kaulketh/outofoffice/hardware/5.83inch E-Paper E-Ink Display HAT For Raspberry Pi, 648×480 Pixels, Black _ White Dual-Color, SPI Interface.jpg

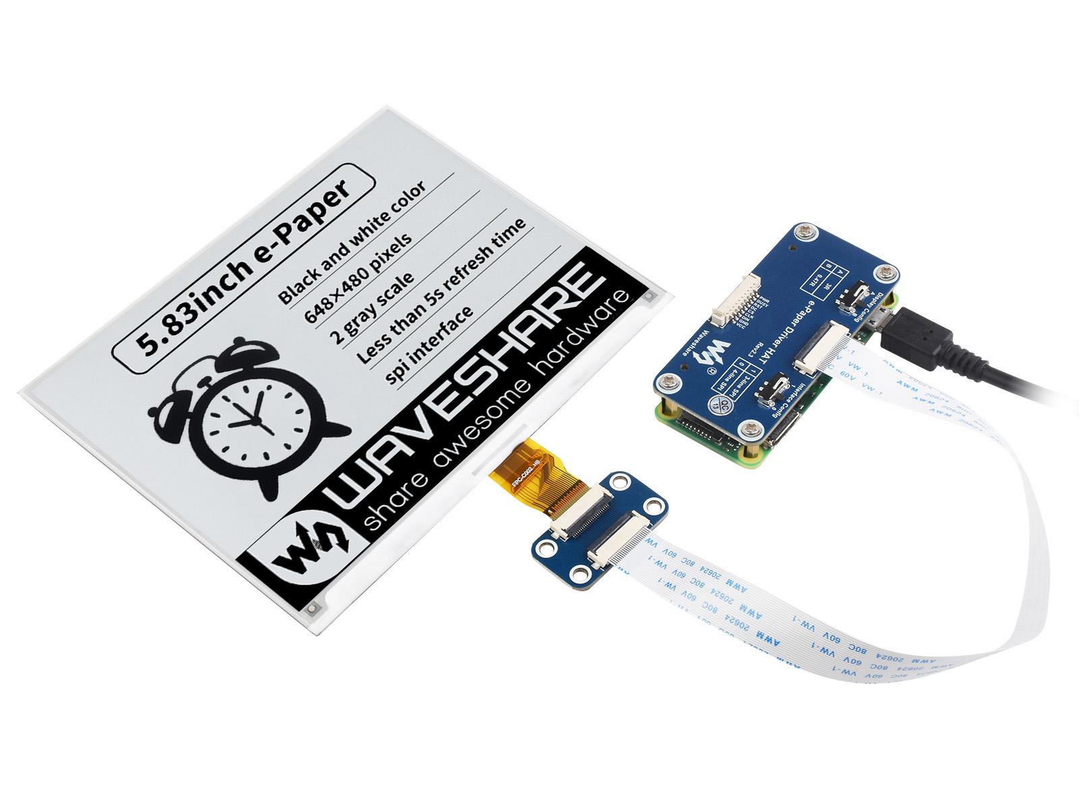
hardware/5.83inch E-Paper E-Ink Display HAT For Raspberry Pi, 648×480 Pixels, Black _ White Dual-Color, SPI Interface.jpg
