kaulketh/outofoffice/hardware/XIAO nrf52840 and I2S - XIAO - Seeed Studio Forum.jpg

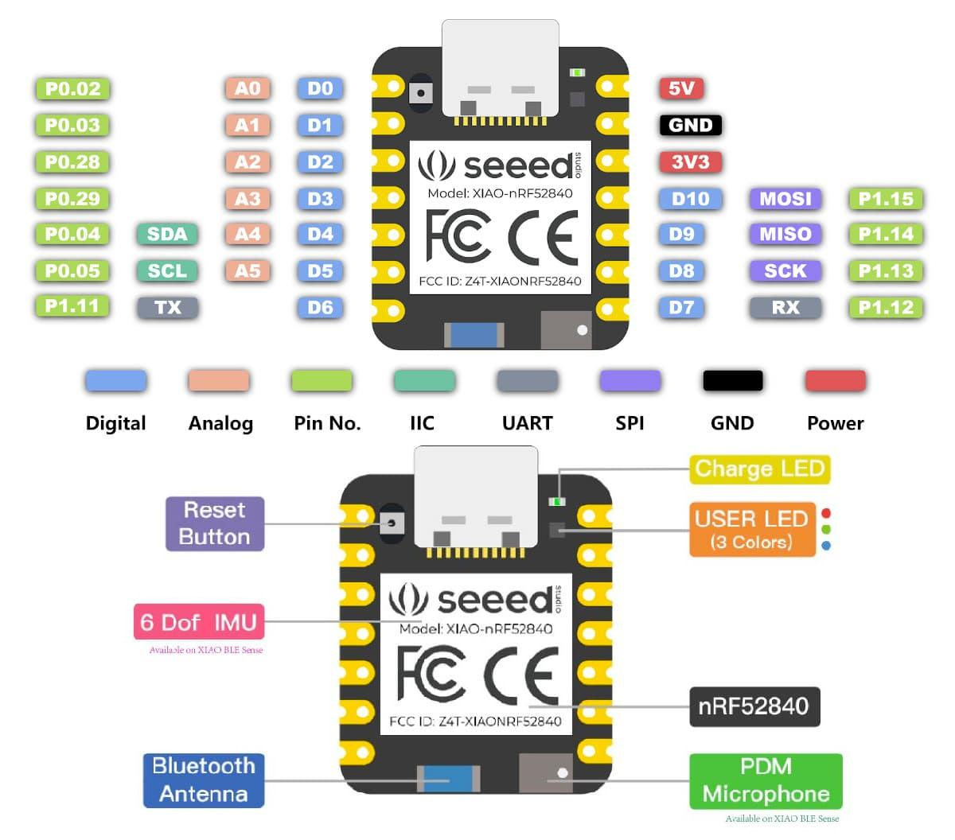
hardware/XIAO nrf52840 and I2S - XIAO - Seeed Studio Forum.jpg
