kaulketh/outofoffice/hardware/3D/xiao cover.stl

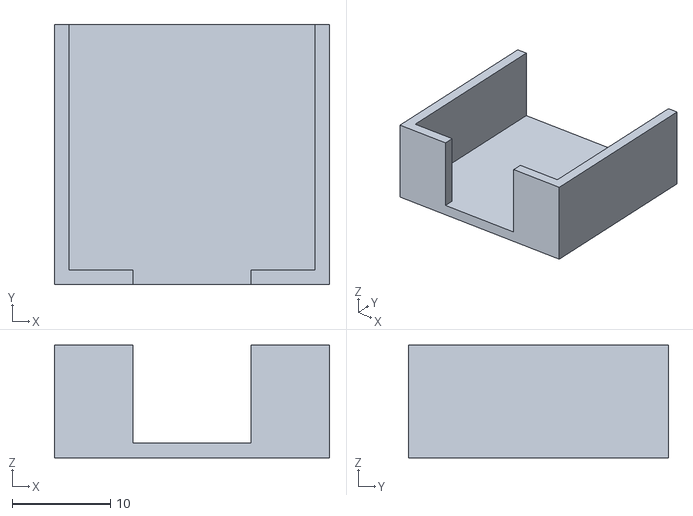
[picture p4: CAD file, 2026-11-11, last stored version]
hardware/3D/xiao cover.stl
28.0 x 26.5 x 11.5
