kaulketh/outofoffice/hardware/3D/enclosure.stl

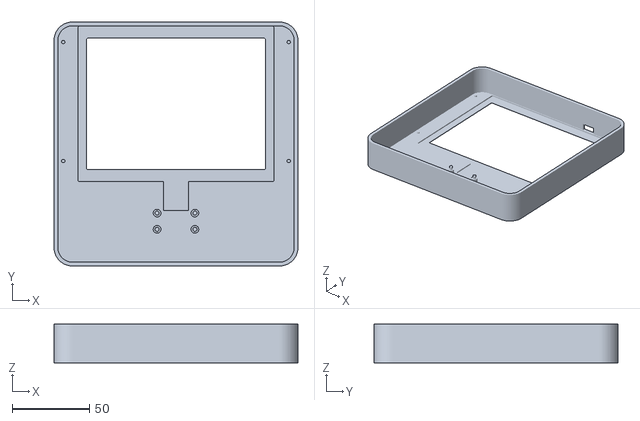
[picture p5: CAD file, 2026-11-11, last stored version]
hardware/3D/enclosure.stl
158.0 x 158.0 x 25.0
