kaulketh/outofoffice/hardware/3D/mount.stl

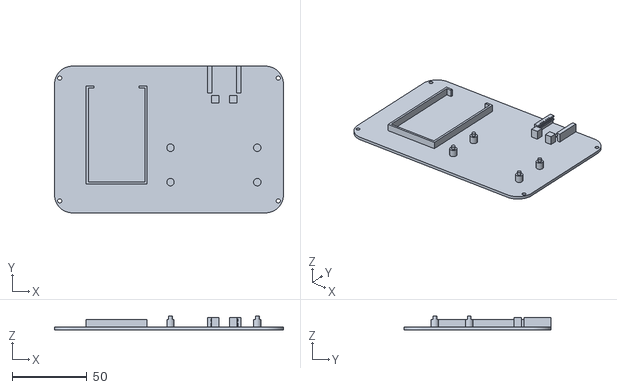
[picture p6: CAD file, 2026-11-11, last stored version]
hardware/3D/mount.stl
153.0 x 98.0 x 9.10
