kaulketh/outofoffice/hardware/3D/adapter cover.stl

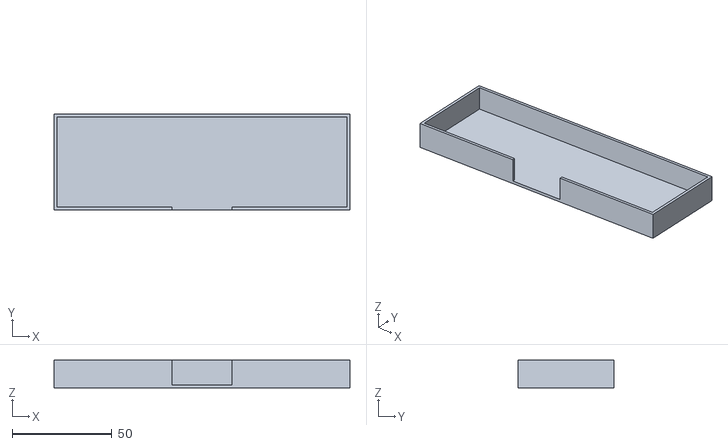
[picture p7: CAD file, 2026-11-11, last stored version]
hardware/3D/adapter cover.stl
148.0 x 48.0 x 13.8
