kaulketh/outofoffice/hardware/wiring.pdf

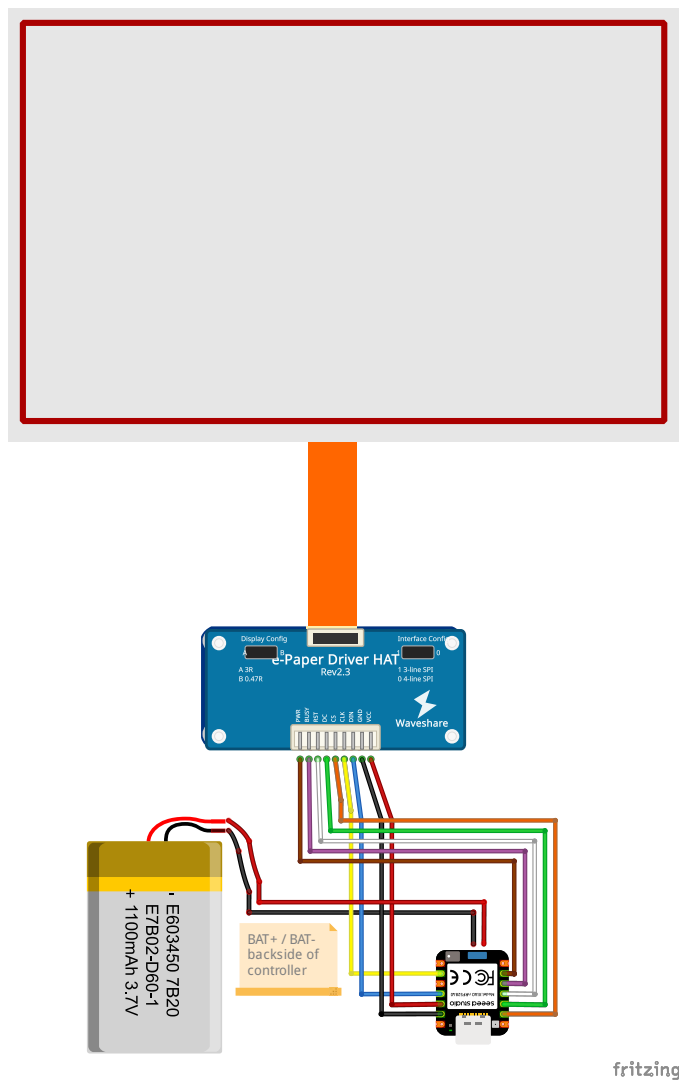
[picture p8: page 1]
BAT+ / BAT- backside of controller
