kaulketh/outofoffice/assets/kaulketh-maker-projects.png

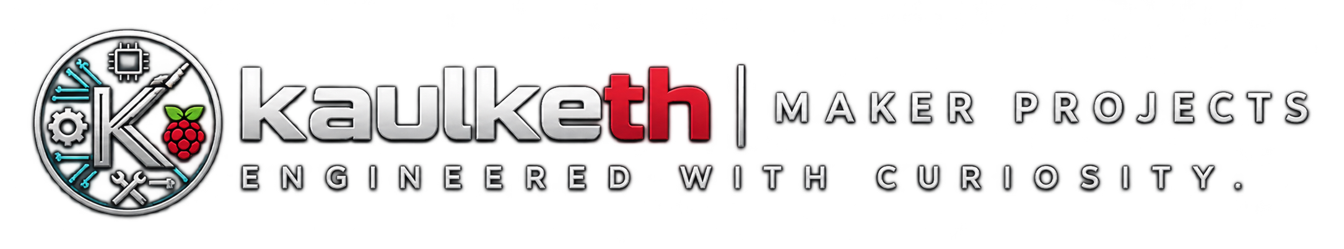
assets/kaulketh-maker-projects.png
