kaulketh/outofoffice/(commit log)

2026-11-07 update battery observing
2026-11-07 Update wiring and connections in setup.txt
2026-11-10 update wiring diagram
2026-11-11 add 3d hardware models
    [adapter cover.stl, enclosure.stl, mount.stl, raumschild_v3.scad, xiao cover.stl]
2026-11-11 Revert "add 3d hardware models"
    This reverts commit 3317d23fed9a0316b497be12c45f46e363138fec.
    [adapter cover.stl, enclosure.stl, mount.stl, raumschild_v3.scad, xiao cover.stl]
2026-11-11 allow all BLE NUS devices
2026-11-11 filter BLE devices by NUS service
2026-11-11 update BLE device naming and title
    [configuration.h]
2026-11-12 remove BLE device name display and update cache version
